wattnotions/OpenHydro/sensor_node_PCB/v0.3_JLCPCB_ORDER_FILES/sensor_node_PCB_v0.3.jpg

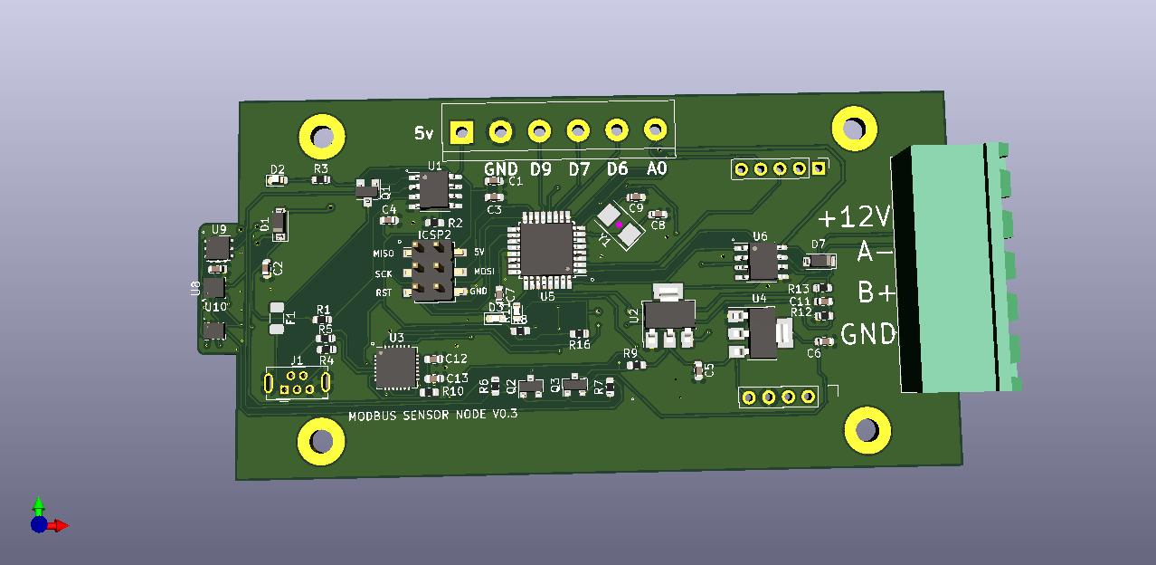
sensor_node_PCB/v0.3_JLCPCB_ORDER_FILES/sensor_node_PCB_v0.3.jpg
