wattnotions/OpenHydro/Documentation/Project_spec/drawing.pdf

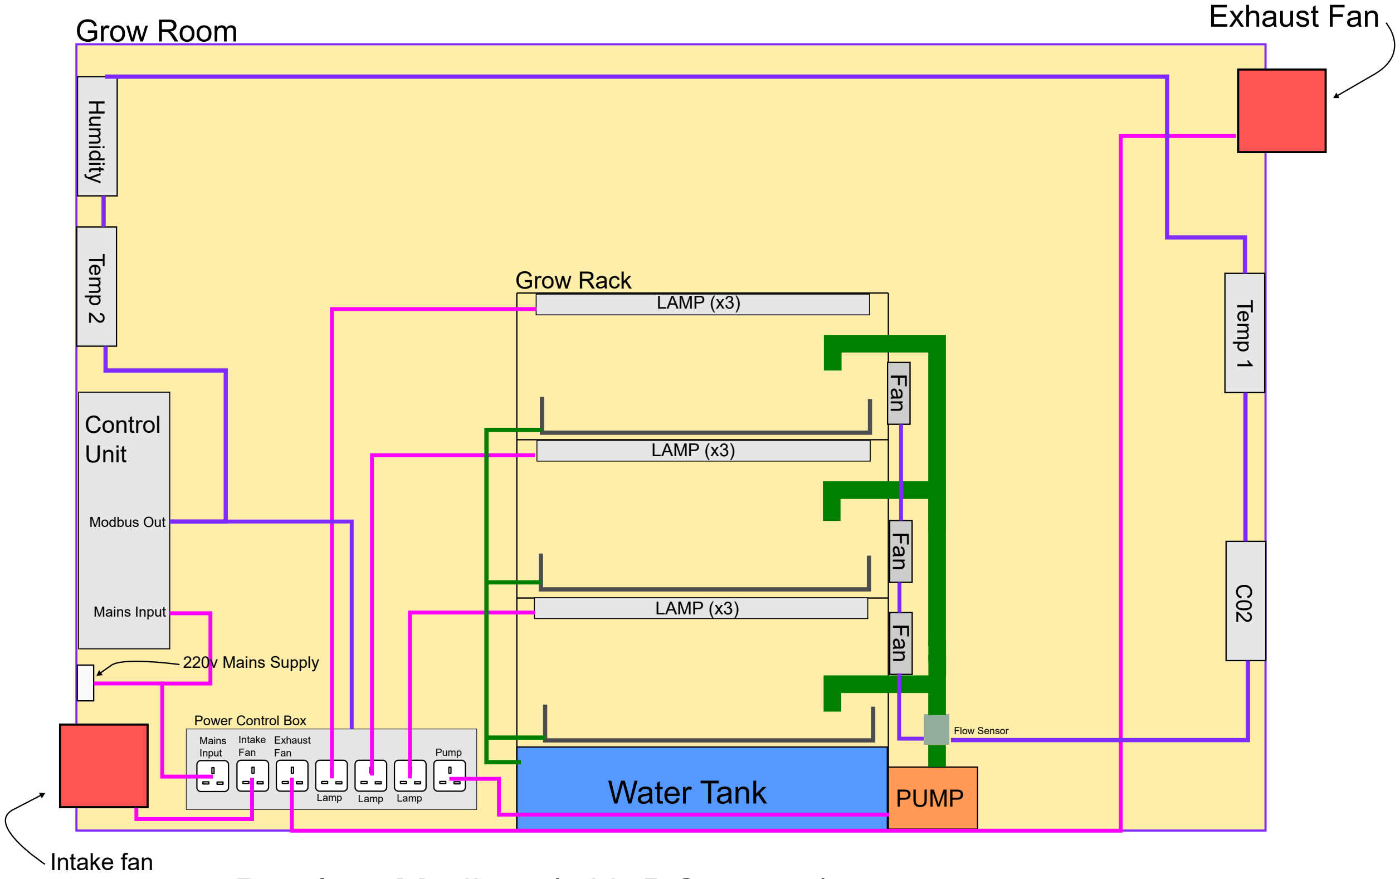
[picture p2: figure]
Grow Room; Exhaust Fan; Water Tank; PUMP; LAMP (x3); Intake fan; Grow Rack; C02 Temp 1; Temp 2; Control Unit; Intake Fan; Lamp; Lamp Lamp; Pump; Power Control Box; Mains Input; Mains Input Humidity; Flow Sensor; 220v Mains Supply; Modbus Out; Fan Fan Fan

# Purple = Modbus (with DC power) Green = Plumbing Pink = 220v
