wattnotions/OpenHydro/Documentation/Project_spec/system_diagram.png

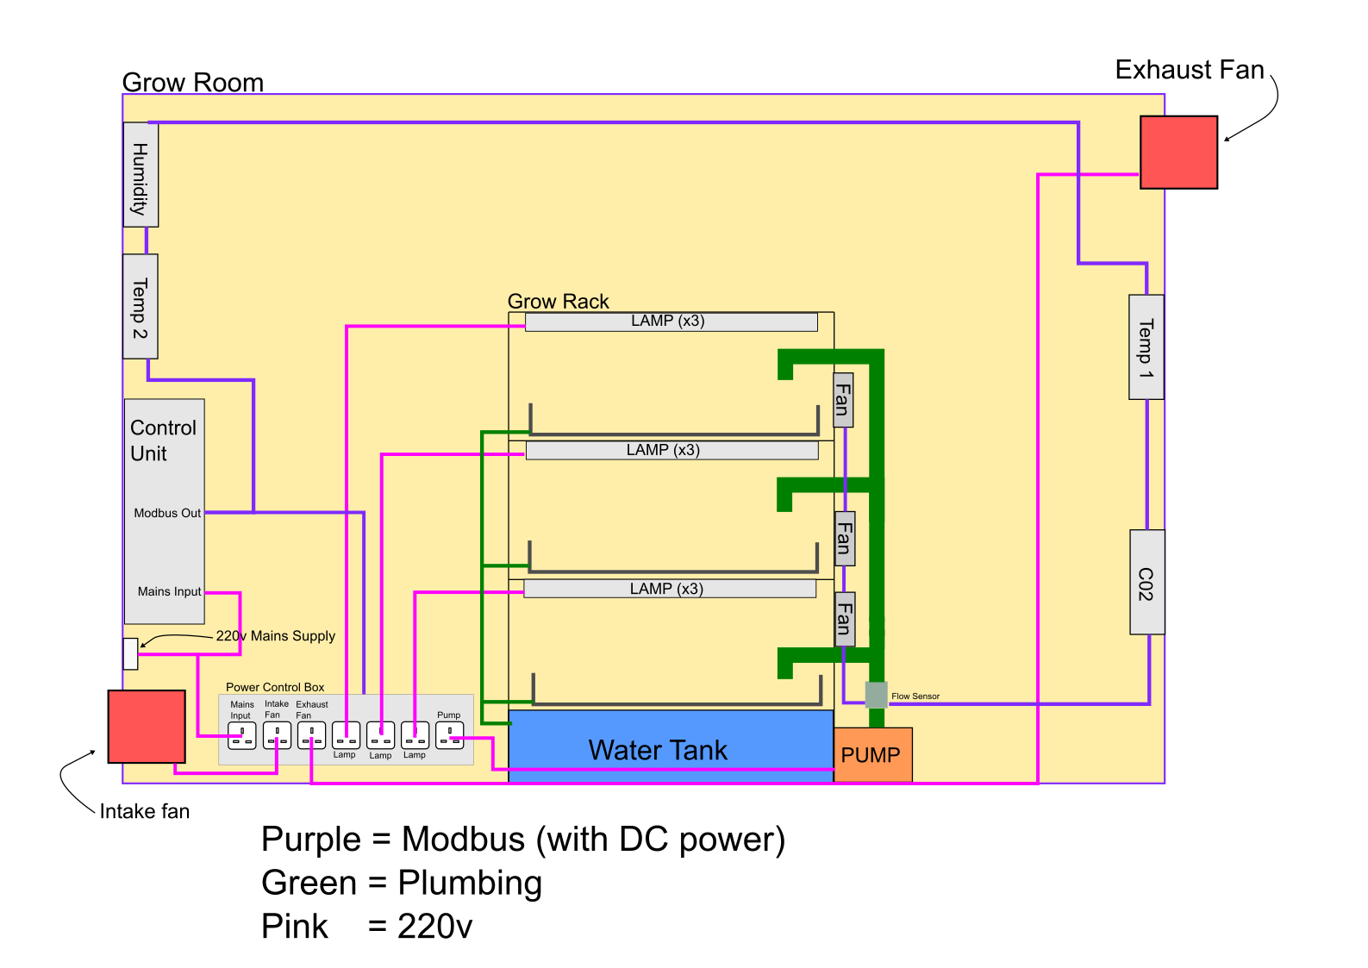
Documentation/Project_spec/system_diagram.png
