wattnotions/OpenHydro/0-10v_PCB/pwm_0-10v/v0.2_JLCPCB_ASSEMBLY_FILES/untitled_top_bom.csv

Comment | Designator | Footprint | LCSC Part #
1.5k | R4 R5 R6 | M0805
10k | R1 R2 R3 | M0805
10uF | C1 C2 C3 | C0805
OP07CDR | U1 U2 U3 | SOIC127P599X175-8N
