wattnotions/OpenHydro/sensor_node_PCB/case_3d_print_files/base v9.stl

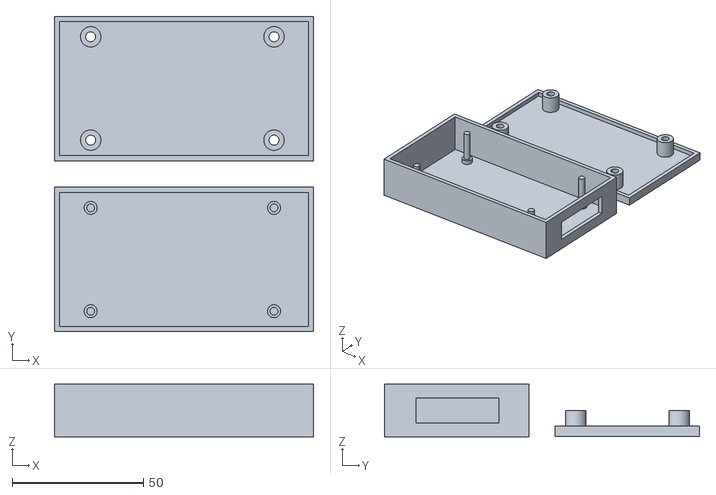
[picture p5: CAD file, 2020-12-12]
sensor_node_PCB/case_3d_print_files/base v9.stl
98.8 x 120.0 x 20.0
