wattnotions/OpenHydro/sensor_node_PCB/case_3d_print_files/pcb_mount_v1/pcb v7.stl

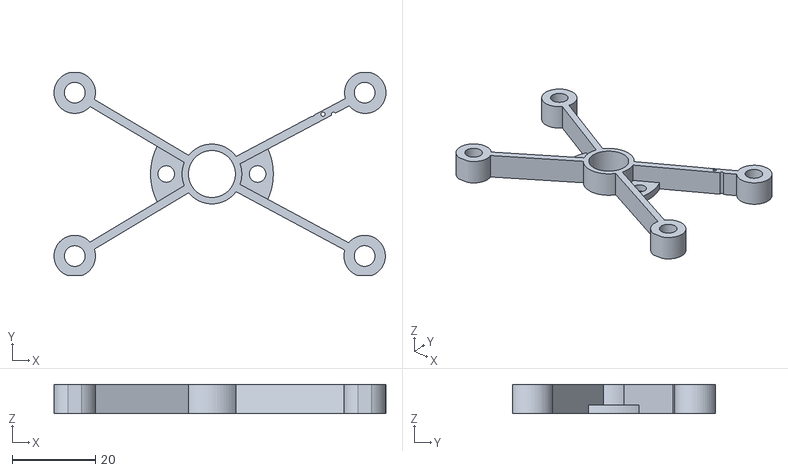
[picture p6: CAD file, 2020-12-30]
sensor_node_PCB/case_3d_print_files/pcb_mount_v1/pcb v7.stl
80.0 x 49.0 x 7.00
