wattnotions/OpenHydro/Arduino_PLC/arduino_programs/Production_scripts/Sensor_node/Sensor_node.ino

/**
 *  Modbus slave example 3:
 *  The purpose of this example is to link a data array
 *  from the Arduino to an external device through RS485.
 *
 *  Recommended Modbus Master: QModbus
 *  http://qmodbus.sourceforge.net/
 */

#include <ModbusRtu.h>

#include <Wire.h>
#include <SPI.h>
#include <Adafruit_Sensor.h>
#include <Adafruit_BME280.h>

#include <SoftwareSerial.h>

SoftwareSerial modbus(2, 3); // RX, TX

// assign the Arduino pin that must be connected to RE-DE RS485 transceiver
#define TXEN	8 

//bme280 defs
#define BME_SCK 13
#define BME_MISO 12
#define BME_MOSI 11
#define BME_CS 10
#define SEALEVELPRESSURE_HPA (1013.25)

Adafruit_BME280 bme; // I2C
unsigned long delayTime;

// data array for modbus network sharing
uint16_t ModbusSReg[8] = {1112,232,344,9,5,6,7,8};   //modbus slave registers

//senseair s8 defs
SoftwareSerial s8_Serial(4,5);   

byte readCO2[] = {0xFE, 0X44, 0X00, 0X08, 0X02, 0X9F, 0X25};  //Command packet to read Co2 (see app note)
byte response[] = {0,0,0,0,0,0,0};  //create an array to store the response

//multiplier for value. default is 1. set to 3 for K-30 3% and 10 for K-33 ICB
int valMultiplier = 1;


Modbus slave(1,modbus,TXEN); // this is slave @1 and RS-485

void setup() {
  Serial.begin( 19200 ); // baud-rate at 19200

  //set up Modbus / rs485
  modbus.begin(19200);
  pinMode(TXEN, OUTPUT);
  slave.start();

  //set up bme280
  unsigned status;
  status = bme.begin(0x76);  

  //set up s8 serial
  s8_Serial.begin(9600); 
  
  if (!status) {
      Serial.println("Could not find a valid BME280 sensor, check wiring, address, sensor ID!");
      Serial.print("SensorID was: 0x"); Serial.println(bme.sensorID(),16);
      Serial.print("        ID of 0xFF probably means a bad address, a BMP 180 or BMP 085\n");
      Serial.print("   ID of 0x56-0x58 represents a BMP 280,\n");
      Serial.print("        ID of 0x60 represents a BME 280.\n");
      Serial.print("        ID of 0x61 represents a BME 680.\n");
     
  }
  
  modbus.listen();
}

int i;
int num_bytes=0;
void loop() {

  
  slave.poll( ModbusSReg, 8 );

  
  getSensorValues(i);

  if(i == 100) {i=0;}
  i++;
}


//gets sensor values and puts them into modbus array
//this array is then polled and sent via modbus
void getSensorValues(int i) {

    static int temp, pres, hum;
 //   Serial.print("Temperature = ");
    temp = int(bme.readTemperature()*100);
    ModbusSReg[0] = temp;
 //   Serial.print(temp);
 //   Serial.println(" *C");

//    Serial.print("Pressure = ");
    pres = int(bme.readPressure() / 100.0F);
    ModbusSReg[1] = pres;
  //  Serial.print(pres);
  //  Serial.println(" hPa");

  //  Serial.print("Humidity = ");
    hum = int(bme.readHumidity()*100);
    ModbusSReg[2] = hum;
  //  Serial.print(hum);
  //  Serial.println(" %");
    Serial.println(i);
    if (i == 100){
      s8_Serial.listen();
      sendRequest(readCO2);
      uint16_t valCO2 = getValue(response);
      modbus.listen();
      ModbusSReg[3] = valCO2;
      Serial.println(valCO2);
    }

 //   Serial.println();
}

void sendRequest(byte packet[])
{
  while(!s8_Serial.available())  //keep sending request until we start to get a response
  {
    s8_Serial.write(readCO2,7);
    delay(50);
  }
  
  int timeout=0;  //set a timeoute counter
  while(s8_Serial.available() < 7 ) //Wait to get a 7 byte response
  {
    timeout++;  
    if(timeout > 10)    //if it takes to long there was probably an error
      {
        while(s8_Serial.available())  //flush whatever we have
          s8_Serial.read();
          
          break;                        //exit and try again
      }
      delay(50);
  }
  
  for (int i=0; i < 7; i++)
  {
    response[i] = s8_Serial.read();
  }  
}

unsigned long getValue(byte packet[])
{
    int high = packet[3];                        //high byte for value is 4th byte in packet in the packet
    int low = packet[4];                         //low byte for value is 5th byte in the packet

  
    unsigned long val = high*256 + low;                //Combine high byte and low byte with this formula to get value
    return val* valMultiplier;
}
