wattnotions/OpenHydro/(commit log)

2020-08-30 created kicad project
    [sensor_node_PCB.kicad_pcb, sensor_node_PCB.sch]
2020-09-01 added arduino uno schematic
    [ATMEGA16U2-2020-09-01-09-36-00.sch, ATMEGA16U2-2020-09-01-09-39-46.sch, ATMEGA16U2.sch, ATMEGA328P-2020-09-01-09-36-00.sch, ATMEGA328P-2020-09-01-09-39-46.sch, ATMEGA328P.sch, Arduino_Uno_R3_From_Scratch-2020-09-01-09-36-00.sch, Arduino_Uno_R3_From_Scratch-2020-09-01-09-39-46.sch]
2020-09-01 removed 3.3v reg and changed to 4 pin conn input
    [voltage_management.sch]
2020-09-01 added usb circuitry
2020-09-01 added modbus connectors
    [sensor_node_PCB.sch]
2020-09-01 changed 12v input to global label
    [sensor_node_PCB.sch, voltage_regulator.sch]
2020-09-01 added 3.3v regulator
    [atmega328p.sch, sensor_node_PCB.sch, voltage_management.sch]
2020-09-02 changed rs485 transceiver to sp485e
    [sensor_node_PCB.sch]
2020-09-02 started bme280 wiring
    [sensor_node_PCB.sch]
2020-09-03 added sensair s8
    [sensor_node_PCB.sch]
2020-09-03 added level shifter for bme280
    [sensor_node_PCB.sch]
2020-09-03 changed bme280 to use i2c
    [atmega328p.sch, sensor_node_PCB.sch]
2020-09-03 ADDED BREAKOUT PINS
    [atmega328p.sch, sensor_node_PCB.sch]
2020-09-04 schematic finished
    [sensor_node_PCB.sch]
2020-09-04 assign footprints 80% completed
    [atmega328p.sch, sensor_node_PCB.sch]
2020-09-05 routing started 15%
    [atmega328p.sch, sensor_node_PCB.kicad_pcb, sensor_node_PCB.sch]
2020-09-06 routing 50%
    [sensor_node_PCB.kicad_pcb, sensor_node_PCB.sch]
2020-09-06 routing 60% completed
    [sensor_node_PCB.kicad_pcb, sensor_node_PCB.sch]
2020-09-06 started placing mounting holes
    [sensor_node_PCB.kicad_pcb]
2020-09-06 edge cuts layer with mounting holes complete
    [sensor_node_PCB.kicad_pcb]
2020-09-06 routing complete
    [sensor_node_PCB.kicad_pcb]
2020-09-07 made 12v bus line bigger and moved away from bme280
    [sensor_node_PCB.kicad_pcb]
2020-09-07 added missing dtr trace
    [sensor_node_PCB.kicad_pcb]
2020-09-07 moved vin trace away from bme280
    [sensor_node_PCB.kicad_pcb]
2020-09-07 fixed senseair s8 pin mixup - added lots of silk text
    [sensor_node_PCB.kicad_pcb, sensor_node_PCB.sch]
2020-09-08 changed board outline to rectangle
    [sensor_node_PCB.kicad_pcb]
2020-09-14 added json print just to see formatting
2020-09-21 fixed incorrect atmega328p pinout
    [atmega328p.sch, sensor_node_PCB.csv]
2020-09-21 cleaned up drc violations
    [sensor_node_PCB.kicad_pcb]
2020-09-21 removed 2nd connector - fixed mounting holes
    [atmega328p.sch, sensor_node_PCB.kicad_pcb, sensor_node_PCB.sch]
2020-09-23 generated files for jlcpcb fab
    [sensor_node_PCB-B_Cu.gbr, sensor_node_PCB-B_Mask.gbr, sensor_node_PCB-B_Paste.gbr, sensor_node_PCB-B_SilkS.gbr, sensor_node_PCB-Edge_Cuts.gbr, sensor_node_PCB-F_Cu.gbr, sensor_node_PCB-F_Mask.gbr, sensor_node_PCB-F_Paste.gbr]
2020-10-03 silkscreen cleanup
    [sensor_node_PCB.kicad_pcb]
2020-10-03 added s8 modbus/uart datasheet
2020-10-24 temp, humidity and pressure mqtt send working
2020-12-12 made eagle project
    [untitled.sch]
2020-12-12 added sensor node case 3d print files
    [base v9.stl]
2020-12-12 added analog circuitry
    [untitled.sch]
2020-12-12 made .brd file
    [untitled.brd]
2020-12-13 part placement completed
    [untitled.sch]
2020-12-19 made centroid file
    [BOM_v1.csv, top_centroid_v1.csv, untitled.brd]
2020-12-19 added external tab for bme280 ic
    [sensor_node_PCB.kicad_pcb]
2020-12-19 moved bme280 to tab
    [sensor_node_PCB.kicad_pcb]
2020-12-19 added tab to gnd fill zone
    [sensor_node_PCB.kicad_pcb]
2020-12-19 put curved edges on tab
    [sensor_node_PCB.kicad_pcb]
2020-12-19 replaced missing gnd plane
    [sensor_node_PCB.kicad_pcb]
2020-12-19 fixed max485 wiring issues on schematic
    [atmega328p.sch, sensor_node_PCB.sch]
2020-12-19 routed max485 en to ard d8
    [sensor_node_PCB.kicad_pcb, sensor_node_PCB.sch]
2020-12-19 added sht20 to tab
    [sensor_node_PCB.kicad_pcb]
2020-12-20 added dps310 to schem and board
    [sensor_node_PCB.kicad_pcb, sensor_node_PCB.sch]
2020-12-20 changed term block to 5.08mm - added silk pin labels
    [sensor_node_PCB.kicad_pcb, sensor_node_PCB.sch]
2020-12-20 changed usb ic to cp2102 on schematic
    [atmega328p.sch, sensor_node_PCB.sch]
2020-12-20 cp2102 routing complete
    [sensor_node_PCB.kicad_pcb]
2020-12-20 added status led to pin 25
    [sensor_node_PCB.kicad_pcb]
2020-12-20 made term block silk invisible
    [sensor_node_PCB.kicad_pcb]
2020-12-20 changed cp2102 to 28 pin version
    [atmega328p.sch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]
2020-12-20 generated fab files
    [sensor_node_PCB-B_Cu.gbr, sensor_node_PCB-B_Mask.gbr, sensor_node_PCB-B_Paste.gbr, sensor_node_PCB-B_SilkS.gbr, sensor_node_PCB-Edge_Cuts.gbr, sensor_node_PCB-F_Cu.gbr, sensor_node_PCB-F_Mask.gbr, sensor_node_PCB-F_Paste.gbr]
2020-12-30 changed screw terminals to correct size
    [untitled.brd, untitled.sch]
2020-12-30 kicad files
    [modbus0-10v.kicad_pcb, modbus0-10v.sch]
2020-12-30 added silk screen text
    [untitled.brd]
2020-12-30 added 1.5k pull down resistor to all inputs
    [pcb v7.stl, untitled.brd, untitled.sch]
2020-12-30 added board name + version to silk text
    [untitled.brd]
2020-12-30 made board a bit bigger
    [untitled.brd]
2020-12-30 fixed silk text wrong layer
    [untitled.brd]
2020-12-30 fixed another silk issue- generated gerbers for v0.2
    [untitled.brd]
2020-12-30 changed pulldown resistors to 1.5k instead of 10k
    [untitled.brd, untitled.sch]
2021-03-06 got JSON parse working
    [sensor_node_PCB.sch, top_centroid_v0.2.csv, top_centroid_v1.csv, untitled_top_bom.csv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]
2021-03-06 fixed bug with SP update func
    [PLC_master.ino]
2021-03-08 fixed bug with temp SP knob update
    [PLC_master.ino]
